infamy/smd-magazines/images/why-xl-foot-must-deepen.png

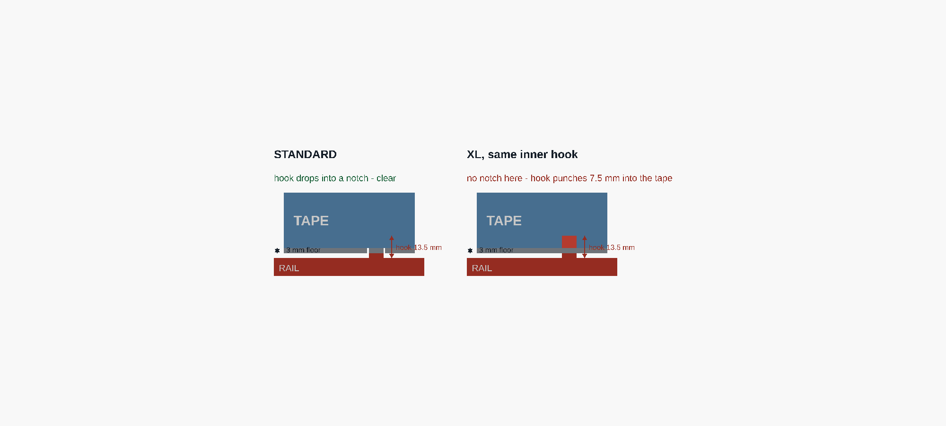
images/why-xl-foot-must-deepen.png
