infamy/smd-magazines/scad/upstream/rail_100mm.stl

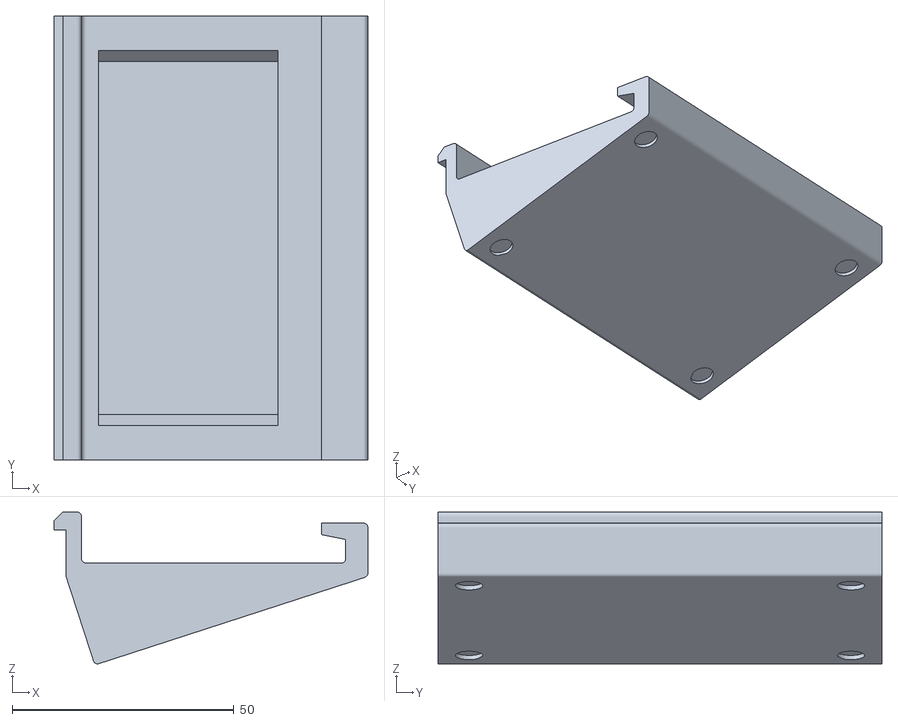
[picture p8: CAD file, 2026-08-18]
scad/upstream/rail_100mm.stl
70.7 x 100.0 x 34.2
