infamy/smd-magazines/scad/upstream/Body_8mm.stl

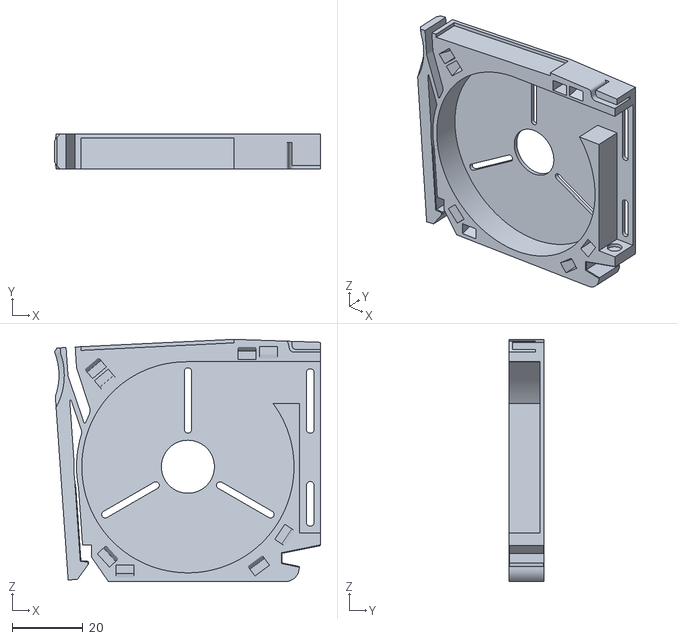
[picture p9: CAD file, 2026-08-18]
scad/upstream/Body_8mm.stl
75.2 x 10.0 x 68.5
