infamy/smd-magazines/scad/upstream/Lid.stl

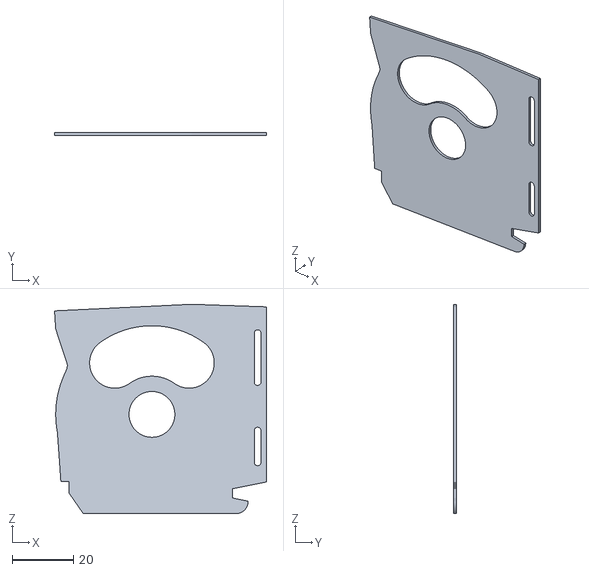
[picture p10: CAD file, 2026-08-18]
scad/upstream/Lid.stl
69.4 x 0.92 x 68.5
