infamy/smd-magazines/scad/upstream/Slider_8mm.stl

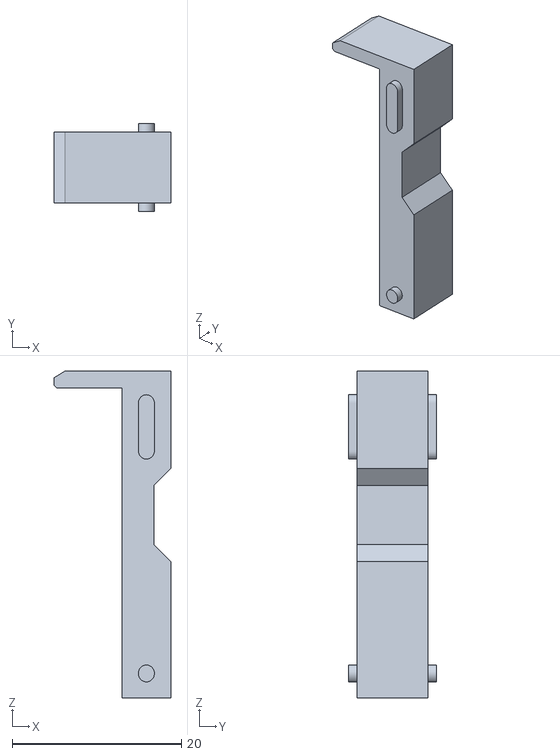
[picture p11: CAD file, 2026-08-18]
scad/upstream/Slider_8mm.stl
13.8 x 10.4 x 38.6
