infamy/smd-magazines/(list of files, cad)

Other CAD files:
src/container.scad
src/rail.scad
