infamy/smd-magazines/(commit log)

2026-08-18 Initial checking
    [Body_8mm.stl, Lid.stl, Slider_8mm.stl, container.scad, hardware.scad, magazine_plate.scad, rail.scad, rail_100mm.stl]
2026-08-19 XL Clip
    [container.scad]
2026-08-26 XL clip reinforcement, correct facets, and fixes from printed parts
    Two rounds of work: the XL clip, then a set of corrections driven by
    faults found on parts in hand.
    $fn never reached any exported geometry. It was set in container.scad and
    rail.scad, but $fn is a special variable resolved from the CALL SITE and
    `use <>` does not carry it, so every build ran at OpenSCAD's coarse
    default. The M2.5 tap holes shipped as pentagons 1.66mm across the flats
    against a 2.05mm design - 19% undersize. Set at the top level of each
    entry point instead. Everything previously printed is affected.
    Magazines now build once per nozzle. The badge recess is exactly one
    first layer deep, so its depth is a pro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
    [container.scad, fit_check.3mf, hardware.scad, rail.scad]
2026-08-26 Add the reel intake bench: scan a code, get the magazine and its label
    A single self-contained page. Scan a DigiKey or Mouser Data Matrix, an
    LCSC/JLCPCB QR, or type a part number, and it answers the two questions
    worth answering at intake: which magazine to print, and what goes on its
    card.
    Which magazine. Tape width comes from the package per EIA-481, read out of
    the manufacturer part number where that number carries it - Yageo RC, Vishay
    CRCW, Panasonic ERJ, Samsung CL, Murata GRM, AVX. Standard against XL is
    capacity against the reel quantity, from pi(r^2 - r_hub^2)/(carrier * pitch)
    with the README's own pocket radii; calibrated to 801 and 1678 against its
    published ~800 and ~1600 of 0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
2026-08-26 One label size for every tape width, and drop the tolerance code
    Size. Every card now lays out inside the same fixed-height box regardless of
    the tape it is for, so a 10k on 8mm and a 10k on 16mm print at identical
    size and a rail of mixed widths reads as one set. The 8mm card is the
    smallest so it sets the size; the larger cards carry the difference as blank
    above and below. Badge 2.91mm cap, value 4.94mm, 0.40mm strokes - the same
    three numbers on 8, 12 and 16mm where they used to be 2.91/4.60/0.40,
    4.50/6.13/0.65 and 6.10/5.61/0.85.
    Tolerance. The EIA letter is gone. "F" is what the reel prints and it does
    mean 1%, but nobody reading a card at arm's length knows that, which is the
    only t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
2026-08-26 Make the badge a full-height band, and measure the card between glyphs
    The badge was an interior pocket in the lid, so it had to stop short of the
    card edge. It is a groove now: the block ends at zCut across the band's
    width, the second filament fills it to zTop, and the digits are left
    standing in it as pillars of card. That lets it run the full height of the
    card and off its end, which is what a band is. Everything right of it is
    unchanged - ordinary card with the value sunk into its lid.
    Two bugs the rebuild surfaced.
    The print check was measuring the wrong thing. It ran a stroke width scan on
    the lettering and then again on the reversed-out digits, which is the same
    measurement twice: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
2026-08-26 Set four-character badges in two rows, and measure counters
    The middle of the 0 was closing up, and neither existing check could see it.
    thinnestStroke measures the strokes of the lettering; minGap measures the
    card standing between two glyphs. A counter is neither - it is a hole inside
    a single glyph - so both scans walked straight past a feature sitting at
    0.40mm on a 0.4mm nozzle. minCounter closes that: invert, label, discard the
    component that reaches the border since that is the open background, and
    every component left is an enclosed counter. On 0603 it found three of them,
    the two zeros and the six, all at exactly one bead.
    No amount of face or tracking work fixes that in one row. T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
2026-08-26 Split badges at the hyphen, and add a sample sheet
    SOD-123 was being cut in half as "SOD-" over "123", dragging the hyphen into
    a row and setting the cap height off four characters instead of three.
    Splitting at the hyphen and dropping it reads as the package it actually is
    and buys back the character: SOD-123 goes 0.40 -> 0.55mm, SOT-23 0.60 ->
    0.65mm. TQFP-48 is unchanged because TQFP is four characters either way.
    reference/renders/labels-sample.png is eight labels at actual size straight
    out of the tool's own renderer, not a mock-up - the same layout that feeds
    the mesh.
2026-08-26 Decode the Ralec RS series, R-notation values and zero-ohm jumpers
    RS-05K1001FT went through as an undecoded part number - no value, no
    package, so no badge and no tape width either. It is one of the most common
    things on an LCSC order, so it is worth reading properly: 1001 is the
    standard EIA four-digit code for 1k and F is 1%, which is certain, and the
    two digits after RS- give the case size.
    That size reading is inferred, not documented here: 02/03/05/06 follow the
    second pair of the EIA code, so RS-05 is 0805. It lands in the package
    picker where it is visible and correctable before anything is printed,
    rather than being asserted in the recommendation.
    Two more that were silently faili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
2026-08-26 Read part numbers by their coding rather than by their vendor
    Three reels in a row arrived in formats nothing here knew - Ralec RS-,
    Uniohm 0805W8F..., Yageo CC0805KRX7R... - and each one was going to be
    another special case. The coding underneath them is not vendor-specific
    though: a four-digit resistance code is three digits of mantissa and a
    decade, the mantissa is always an E-series value, and the tolerance letter
    sits immediately beside it. Checking the mantissa against E24 and E96 is a
    tight enough filter to read a resistance out of a part number nobody has
    written a rule for, because a date code or an order reference will not land
    on an E96 step AND carry a tolerance letter next to it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
2026-08-26 Parse barcodes whose separators were stripped, and read trailing R/K/M values
    The GS bytes that separate ISO 15434 fields are non-printing, so a clipboard
    loses them and some scanners strip them. Without them the old fallback hunted
    for "the next field identifier", which cannot work: P, K, T, D and L all
    occur inside part numbers, so RNCP0603FTD1K00CT-ND was chopped at its own P
    and the reel came through as part number "RNC" with no manufacturer part at
    all. Everything downstream - value, package, tape width, which magazine to
    print - followed from that.
    The field order is fixed, so match on structure instead. The manufacturer
    part ends where the order block begins, and that block is K<po>1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
2026-08-26 Let the tape width be chosen directly, not only through a package
    Plenty of parts have no tidy package name - connectors, modules, crystals,
    anything odd - but the tape they came on is printed on the reel. The picker
    only offered packages, so those parts had to be forced into an approximate
    one to get a tape width out of it.
    The list now opens with 8, 12 and 16 mm tape as choices in their own right,
    under "I know the tape width", with the packages below under "I know the
    package". Choosing a width sets pitch and carrier to middling values for
    that width and leaves both overridable, and the recommendation says "12 mm
    tape because you set it" rather than pretending it inferred it.
    A width-on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
2026-08-26 Lean the magazine choice to XL, and put the pick first
    Standard against XL was decided by comparing the reel quantity to a computed
    capacity, and then trusted right down to the last piece. That is false
    precision: the most sensitive term in that capacity is carrier thickness,
    which is a dropdown rather than a measurement, so a call made at 99% of a
    standard rests on a number that could be 20% out.
    Standard now has to be a clear win - the reel fits inside three quarters of
    one. Anything tighter goes XL, and so does a reel that does not say how much
    is on it. That is the cheap direction to be wrong in: a half-empty XL costs
    some filament, while a standard that turns out too small costs a repr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
2026-08-26 Prepare for public release: licensing, and source only in the tree
    Licensing. Two of the three upstreams - tobi's parametric remix and Varner's
    edition - are CC-BY-SA 4.0, which is share-alike, so the design has no free
    choice: LICENSE is the verbatim CC-BY-SA 4.0 text and covers the SCAD, the
    imported profiles, the renders and this documentation. The software written
    here is MIT instead, in LICENSE-MIT: the label maker and the build tooling.
    Creative Commons advise against their licences for code, and MIT lets people
    lift the label generator without inheriting share-alike from a resistor
    holder. Every MIT file carries an SPDX-License-Identifier line so the split
    is per-file rather than a cl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
    [fit_check.3mf]
2026-08-26 Serve the label maker from Pages, and link the magazines from it
    Someone who lands on a hosted label maker has the labeller but not the thing
    the labels go into, and the tool was printing a path - print/0.4mm-nozzle/... -
    that means nothing to a browser. It now works out where it is: served from
    user.github.io/repo it derives github.com/user/repo with no configuration,
    turns its own recommendation into a download link straight to the release
    asset, and links the magazines and rails from the header and the notes. Opened
    as a local file there is nothing to derive from, so it prints the print/ path
    exactly as before; PROJECT_URL is there to point a local copy at the same
    place.
    Moved tools/lab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
2026-08-27 Lay the tree out by what things are, not by where a tool expects them
    Three folders were named after mechanisms rather than contents. docs/ held an
    application because that is one of two places GitHub Pages will serve from.
    reference/ held generated figures, when "reference" implies source material.
    And src/ held three different things under one name - the design, the build
    tooling, and four STLs belonging to someone else - so the licence boundary ran
    straight through a single folder and could only be told apart by opening files
    and reading SPDX lines.
    scad/ the design CC-BY-SA 4.0
    upstream/ LordAsdi's STLs, verbatim CC-BY 4.0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
    [Body_8mm.stl, Lid.stl, Slider_8mm.stl, container.scad, hardware.scad, magazine_plate.scad, rail.scad, rail_100mm.stl]
2026-08-27 Add the publishing set: instructions PDF and both listing descriptions
    Printables and MakerWorld both want a PDF beside the model files, and that
    document has a different job from the README. The README is for someone
    deciding whether the repository is worth their time; the PDF is for someone who
    already has the files and wants to build the thing. So publish/instructions.md
    is its own document - credit and licence, what to print and on which nozzle,
    what to buy, and how it goes together - rather than the README with the
    developer sections cut out.
    tools/make_pdf.py renders it. There is no pandoc or weasyprint here and adding
    one to print three pages would be a poor trade, so it drives headl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
2026-08-27 Credits last in all three listing documents, and the M3 is 16mm
    The credit chain led every document, which put four names and a licence
    paragraph between the reader and what the thing actually is. Moved to the end
    in all three. Attribution is no less present for being at the bottom, and CC-BY
    does not care where it sits, only that it is there and legible.
    Each document now carries a one-line bridge where the chain used to be -
    "What I added" needs something to have been added to, and the instructions
    opened on "What to print" with no hint the design was inherited.
    The M3 is 16mm, from the built part rather than my reading of the geometry.
    It checks out: the slider's clearance bore is 16.01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
2026-08-27 Name the drive type on the M2.5, and note what the recess actually takes
    Countersunk M2.5 ships in cross-recess and hex-socket drive, and the bill of
    materials said only "countersunk", which is the half that does not help anyone
    ordering. Confirmed against the built part: M2.5 x 6mm, hex drive.
    hardware.scad takes its head diameter from DIN 965, which is the cross-recess
    head, so the comment read as though that were the intended screw. It is only
    where the 4.7mm figure comes from. The mouth is head_d + clr = 5.0, and a
    hex-socket countersunk head is also 90 degrees and also within 5.0 across the
    top, so the same recess takes either - which is why the hex ones seat properly.
    Said so in the f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
    [hardware.scad]
2026-08-27 Fix the vertex weld that was splitting meshes, and add a 3MF checker
    Reported: Bambu Studio throws errors on these files.
    make_3mf.py welded vertices with round(c, 6) - six decimal places - and wrote
    them with "%.6g" - six significant digits, which at 30mm is four decimals. The
    two never agreed. Any pair of vertices between 1e-6 and 1e-4 apart was kept as
    two separate indices and then written at identical coordinates, so the file
    declared a seam joined that the topology had split. That is precisely what a
    slicer reports as errors and silently repairs. Twenty of them in one 8mm body,
    in every plate the build has ever produced.
    Both now come from one PRECISION constant, so they cannot drift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
2026-08-27 Record the lib3mf cross-check, and why the writer stays hand-rolled
    lib3mf 2.5.0 reads every plate this build produces without complaint, so the
    hand-written XML is spec-valid rather than merely untested. Its
    IsManifoldAndOriented() then flags exactly the seven plates check_3mf.py
    reports as self-touching - the six XL bodies and rail-xl-100mm - which is two
    independent implementations agreeing, and the reason to trust either.
    Why not adopt it: the writer emits a fixed, small subset and the reference
    library says that subset is correct, against a build that otherwise needs only
    OpenSCAD and the standard library. For checking it is a genuine argument -
    one call against forty lines - but it re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
2026-08-27 Carry the filament assignment where Bambu will actually read it
    The badge arrived on filament 1 like everything else, and had to be reassigned
    by hand on every import - by anyone who downloads this, not only by us. Bambu
    Studio and Orca ignore the core spec's basematerials and take extruder
    assignment from their own Metadata/model_settings.config, so the colours we
    were writing had nowhere to land.
    The schema is copied from a Bambu export of this same plate, sitting in
    archive/, rather than guessed: <object> is the build item's id and <part> is
    each mesh inside it. Body 1, badge 2, lid and slider 1.
    This does not make it a Bambu file. Unknown files under Metadata/ are ignored
    by other slic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
2026-08-27 Stop telling people to assign the filaments by hand
    Confirmed working: the badge now arrives on filament 2 on import. The docs
    still said to assign the two to AMS slots yourself, which was true before
    model_settings.config and is not any more - in the README, the instructions
    PDF, both listing descriptions and the label maker's own print notes.
    Rebuilt all sixteen plates. Every one carries the config, body/lid/slider on
    filament 1 and the badge on 2, and check_3mf.py still reports no faults - the
    22 self-touching edges on the XL bodies are unchanged and unrelated.
2026-08-27 Add the packaging step for Printables and MakerWorld
    Both sites take the same files, so make_upload.py produces one set: a zip of
    the sixteen plates, a zip of every part as a separate STL, and the
    instructions PDF left loose so it can be uploaded as its own file.
    The STLs are rewritten as binary. OpenSCAD emits ASCII, which is four times
    the size for identical geometry - 110MB against 26MB, and 6MB once zipped,
    which is the difference between a comfortable upload and a painful one.
    Nothing is lost but whitespace, and that is checked rather than assumed: all
    sixty files are round-tripped back out of the zip and compared vertex by
    vertex against the originals. Worst coordinate difference 0.01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
2026-08-27 Add mise tasks for the build and publishing flow
    Four commands in a fixed order, one of which gates the rest, is the sort of
    thing worth writing down. `mise run release` builds, verifies, renders the PDF
    and packages the uploads, and stops if the check fails so a bad plate cannot
    reach a zip.
    No [tools] section, deliberately. There is nothing here to pin: every import
    in tools/ is Python standard library, so any python3 works and pinning one
    would have mise install a second interpreter for no benefit. The actual
    dependencies - OpenSCAD, and Chrome for the PDF - are desktop applications
    mise does not manage, so `mise run doctor` checks for them and says how to get
    them, which is the useful h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
2026-08-27 Drop the mise config
    It was buying ordering and costing a tool. There are no dependencies to
    manage here - every import is Python standard library, and OpenSCAD and Chrome
    are desktop applications mise does not install - so a [tools] section would
    have been empty and the whole file was four shell lines in TOML.
    The ordering it encoded is worth keeping, so the README says it in a sentence
    instead: run the check before packaging, because it exits non-zero and a bad
    plate should not reach a zip.
    The scripts were always the real thing; nothing about the build changes.
2026-08-27 Point everything at the real URLs, and fix what the custom domain broke
    The repo is live at github.com/infamy/smd-magazines, and Pages serves it from
    www.meshmeld.com/smd-magazines/ rather than infamy.github.io - the account has
    a custom domain.
    That silently broke the label maker. It derives the repository from the
    hostname, which works for user.github.io/repo and cannot work here, because
    www.meshmeld.com says nothing about what is behind it. The derivation would
    have returned nothing, the download links would not have appeared, and the
    page would have shown local print/ paths on a hosted site - the whole feature
    missing with nothing visibly wrong. PROJECT_URL exists for exactly this and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
2026-08-27 Generate paste-ready listing text, because the markdown pastes in badly
    Printables and MakerWorld use rich-text editors, not markdown fields, and the
    .md descriptions arrive wrong in two separate ways.
    The markup is not interpreted, so **bold**, ## headings, backticks, tables and
    [links](url) all land as literal punctuation.
    Worse, and less obvious: the .md files are wrapped at 80 columns to be readable
    in a terminal, and every one of those wraps is a real newline. The editor
    honours them, so a paragraph pastes in as eight separate lines and the site's
    own wrapping has nothing left to reflow - resize the window and the text stays
    broken where a terminal happened to end a line.
    make_listin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
2026-08-27 Trim the credits Printables now carries in its own remix fields
    LordAsdi and Varner both have Printables models, so both go in the Remix
    fields and repeating them in the description is noise.
    tobi and Robin Reiter stay, because Printables has nothing to link them to.
    tobi's is not a courtesy credit: his parametric rewrite is what container.scad
    and rail.scad are built on, and the share-alike obligation on this whole tree
    comes from his licence. Dropping him would be the one omission here that is
    actually a licence violation.
    MakerWorld's copy is untouched - its remix credit only points at models hosted
    on MakerWorld, so none of the four can be linked there and all four have to
    stay in the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
2026-08-27 They are not wall mounted, and 26 per rail is the 8mm figure
    Two claims in published text that were not checked against anything.
    "Wall-mounted" came in with the initial import and I carried it into the
    README, the instructions PDF and both listing descriptions without ever asking
    whether it was true. It is not: the magazines clip to a rail, and where that
    rail goes is the owner's business. The rail has mounting feet at 95mm centres
    and the instructions now say that instead of inventing a wall for them.
    Fixed in the README, publish/instructions.md, publish/printables.md, the
    regenerated PDF and the paste-ready .txt - and in the GitHub repository's About
    field, which was live and said it to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
2026-10-30 Give each spring segment its own object, and stop the XL ones fusing
    The segments were spaced at a fixed 60mm x pitch sized for the standard
    51.5mm leaf. The XL leaf is 76.5mm wide, so the three XL-300 segments
    overlapped into one slab. Side by side at the right pitch they no longer
    fit beside the rail, so they now stack end to end along y with a 4mm gap.
    All segments were also one mesh, which the slicer treats as one object.
    SEG selects a single segment, and build.sh exports each to its own STL
    and its own 3MF object.
    [rail_plate.scad]
